NickF93/TheSun/README.md

# TheSun
The Sun: a very bright "portable" spotlight
