NickF93/TheSun/hardware/double_pwm_psu/BOM/BOM_Board1_schematic1_2024-10-07.xlsx

No. | Quantity | Comment | Designator | Footprint | Value | Manufacturer Part | Manufacturer | Supplier Part | Supplier
1 | 1 | 22uF | C1 | C0805 | 22uF | CGA0805X5R226M350MT | HRE(芯声) | C6119901 | LCSC
2 | 1 | 22uF | C2 | C0805 | 22uF | CL21A226MAYNNNE | SAMSUNG(三星) | C602037 | LCSC
3 | 2 | 220nF | CCOMP_B1,CCOMP_B2 | C0402 | 220nF | CL05A224KA5NNNC | SAMSUNG(三星) | C47129 | LCSC
4 | 2 | 100pF | CCS_B1,CCS_B2 | C0402 | 100pF | TCC0402COG101K500AT | CCTC(三环) | C696853 | LCSC
5 | 1 | 10uF | CDSP2 | CAP-SMD_L3.2-W1.6-R-RD |  | TAJA106K010RNJ | AVX | C7177 | LCSC
6 | 1 | 10uF | CF1 | CAP-SMD_L3.5-W2.8 |  | CA45-B025K106T | Xiangyee | C119050 | LCSC
7 | 3 | 1uF | CF2,CF3,CF4 | 0402 |  | CL05A105KA5NQNC | SAMSUNG | C52923 | LCSC
8 | 1 | 1nF | CFPWM1 | C0603 | 1nF | FN18X102K500PSG | PSA(信昌电陶) | C525263 | LCSC
9 | 1 | 10uF | CI4 | CAP-SMD_L3.2-W1.6 |  | CA45-A016K106T | Xiangyee | C119051 | LCSC
10 | 2 | 100uF | CIN_B1,CIN_B5 | CAP-TH_BD10.0-P5.00-D0.6-FD-A | 100uF | 1010631012R00 | NJCON(永立) | C2887235 | LCSC
11 | 2 | 10uF | CIN_B2,CIN_B6 | C0805 | 10uF | CL21A106KAYNNNE | SAMSUNG(三星) | C15850 | LCSC
12 | 2 | 1uF | CIN_B3,CIN_B4 | C0402 | 1uF | CL05A105KA5NQNC | SAMSUNG(三星) | C52923 | LCSC
13 | 2 | WAFER-XH2.54-2PZZ | CN1,CN2 | CONN-TH_XH2.54-2P |  | WAFER-XH2.54-2PZZ | XUNPU(讯普) | C5359631 | LCSC
14 | 1 | DBT50G-7.62-3P-BK-P | CNIN1 | CONN-TH_3P-P7.62_L15.2-W24.4-EX4.2 |  | DBT50G-7.62-3P-BK-P | DIBO(地博电气) | C496128 | LCSC
15 | 2 | WJ25C-B-2P | CNOUT_B2,CNOUT_B3 | CONN-TH_2P-P7.62_WJ25C-B-7.62-2P |  | WJ25C-B-7.62-2P | KANGNEX(康奈克斯电气) | C8422 | LCSC
16 | 2 | 330uF | COUT_B1,COUT_B5 | CAP-TH_BD10.0-P5.00-D1.0-FD | 330uF | RG063M331LO10*20TA-1A1E | BERYL(绿宝石) | C357629 | LCSC
17 | 2 | 220uF | COUT_B2,COUT_B8 | CAP-TH_BD10.0-P5.00-D0.6-FD-A | 220uF | SPZ1JM221G15O00RAXXX | AISHI(艾华集团) | C2983797 | LCSC
18 | 4 | 4.7uF | COUT_B3,COUT_B4,COUT_B6,COUT_B7 | C1210 | 4.7uF | FS32X475K101EGG | PSA(信昌电陶) | C381466 | LCSC
19 | 2 | 470pF | COVP_B3,COVP_B4 | C0402 | 470pF | 0402B471K500NT | FH(风华) | C1537 | LCSC
20 | 1 | 10uF | CPI2 | CASE-C_6032 | 10uF | TAJC106K035RNJ | Kyocera AVX | C7211 | LCSC
21 | 1 | 10uF | CSENSE1 | C0402 | 10uF | CL05A106MQ5NUNC | SAMSUNG(三星) | C15525 | LCSC
22 | 1 | 100nF | CSENSE2 | C0402 |  | TCC0402X7R104K160AT | CCTC(三环) | C392963 | LCSC
23 | 1 | B5819W | D1 | SOD-123F_L2.7-W1.6-LS3.8-RD-1 |  | B5819W | GOODWORK(固得沃克) | C2943878 | LCSC
24 | 1 | K7812-1000 | DCDC1 | PWRM-TH_K78XX-1000 |  | K7812-1000 | JETEKPS(健特) | C5199013 | LCSC
25 | 6 | MMSD4148T3G | DCS_B1,DCS_B2,DCS_B3,DCS_B4,DGATE_B1,DGATE_B2 | SOD-123FL_L2.6-W1.6-LS3.4-RD |  | MMSD4148T3G | ONSemicon | C232560 | LCSC
26 | 1 | CUS08F30,H3F | DPWM1 | SOD-323F_L2.0-W1.6-LS2.5-RD |  | CUS08F30,H3F | TOSHIBA(东芝) | C150183 | LCSC
27 | 1 | 2.54-1*4P母 | DSP | HDR-TH_4P-P2.54-V-F |  | 2.54-1*4P母 | BOOMELE(博穆精密) | C2718488 | LCSC
28 | 2 | ST2045 | DS_B1,DS_B2 | TO-277_3P-L5.4-W4.0-LS6.5-BR |  | ST2045 | MDD（MicrodiodeElectronics） | C840773 | LCSC
29 | 1 | XF-507P | F1 | CONN-TH_XF-507P |  | XF-507P | XFCN(兴飞) | C668119 | LCSC
30 | 1 | HF1004E | FAN1 | CONN-TH_4P-P2.54_HF1004E |  | HF1004E | FOXCONN(富士康) | C2761402 | LCSC
31 | 1 | Header-Male-2.54_2x3 | H3 | HDR-TH_6P-P2.54-V-M-R2-C3-S2.54-1 |  | Header-Male-2.54_2x3 | BOOMELE | C65114 | LCSC
32 | 2 | XSD366-094 | HSDRV_B2,HSDRV_B3 | xsd366094 |  | XSD366-094 | XSD |  | LCSC
33 | 4 | 47uH | L_B1,L_B2,L_B4,L_B5 | IND-TH_L17.8-W17.8-P13.00-D0.6 | 47uH | PDPMAA1712-470MP | PROD(谱罗德) | C5119635 | LCSC
34 | 2 | HCB3216KF-300T80 | L_B3,L_B6 | L1206 |  | HCB3216KF-300T80 | TAI-TECH(台庆) | C525677 | LCSC
35 | 2 | LPN1510C | Q_B1,Q_B2 | TO-220-3_L10.0-W4.5-P2.54-L |  | IRFB4110PBF | Infineon Technologies | C2650 | LCSC
36 | 1 | 470Ω | R1 | R0402 | 470Ω | 0402WGJ0471TCE | UNI-ROYAL(厚声) | C25167 | LCSC
37 | 2 | 100Ω | RCSP_B1,RCSP_B2 | R0402 | 100Ω | 0402WGJ0101TCE | UNI-ROYAL(厚声) | C25138 | LCSC
38 | 4 | 60mΩ | RCS_B1,RCS_B2,RCS_B3,RCS_B4 | R2512 | 60mΩ | MA251230FR060FZ | EVER OHMS(天二科技) | C252688 | LCSC
39 | 4 | 130mΩ | RFB_B1,RFB_B2,RFB_B3,RFB_B4 | RES-SMD_L6.4-W3.2-R2512 | 130mΩ | HoLR2512-130mR-1% | Milliohm(毫欧) | C5123648 | LCSC
40 | 1 | 20kΩ | RFPWM1 | R0402 | 20kΩ | SCR0402J20K | VO(翔胜) | C3017501 | LCSC
41 | 7 | 10kΩ | RGATEPD_B1,RGATEPD_B2,RRST2,RSWA,RSWB,RSWC,RSWD | R0402 | 10kΩ | RTT021002FTH | RALEC(旺诠) | C102749 | LCSC
42 | 2 | 10Ω | RGATE_B1,RGATE_B2 | R0402 | 10Ω | 0402WGJ0100TCE | UNI-ROYAL(厚声) | C25139 | LCSC
43 | 2 | 360kΩ | ROVP_B1,ROVP_B4 | R0402 | 360kΩ | 0402WGF3603TCE | UNI-ROYAL(厚声) |  | LCSC
44 | 2 | 18.7kΩ | ROVP_B2,ROVP_B3 | R0402 | 18.7kΩ | 0402WGF1872TCE | UNI-ROYAL(Uniroyal Elec) |  | LCSC
45 | 3 | 1kΩ | RPWM1,RS1,RS2 | R0402 |  | 0402WGJ0102TCE | UNI-ROYAL(厚声) | C25543 | LCSC
46 | 1 | 100Ω | RRST1 | R0402 |  | 0402WGJ0101TCE | UNI-ROYAL(厚声) | C25138 | LCSC
47 | 1 | 220Ω | RSENSE1 | R0402 | 220Ω | 0402WGJ0221TCE | UNI-ROYAL(厚声) | C25151 | LCSC
48 | 2 | 10kΩ | RT1,RT2 | R0402 |  | 0402WGF1002TCE | UNI-ROYAL(厚声) | C25744 | LCSC
49 | 4 | TS4543TP 250gf 009 | SW1,SW2,SW3,SW4 | SW-SMD_4P-L4.5-W4.5-P3.00-LS6.9 |  | TS4543TP 250gf 009 | SHOU HAN(首韩) | C5342984 | LCSC
50 | 1 | TSB008A2518A | SWRST1 | SW-SMD_L6.0-W3.5-LS8.2 |  | TSB008A2518A | BZCN(博众电气) | C2888455 | LCSC
51 | 2 | HC-XH-2A-G | T1,T2 | CONN-TH_2P-P2.50_HC-XH-2A-G |  | HC-XH-2A-G | HCTL(华灿天禄) | C5341201 | LCSC
52 | 1 | AHT20 | U3 | SENSOR-SMD_L3.0-W3.0-P1.00-BR |  | AHT20 | 广州奥松 | C2757850 | LCSC
53 | 1 | ATTINY1616-MNR | U5 | QFN-20_L3.0-W3.0-P0.40-BL-EP1.7 |  | ATTINY1616-MNR | MICROCHIP(美国微芯) | C507118 | LCSC
54 | 1 | SK1117-5.0 | U6 | SOT-223_L6.5-W3.5-P2.30-LS7.0-BR |  | SK1117-5.0 | SHIKUES(时科) | C165483 | LCSC
55 | 2 | AL3353S-13 | UCTRL_B1,UCTRL_B2 | SOIC-8_L4.9-W3.9-P1.27-LS6.0-BL |  | AL3353S-13 | DIODES(美台) | C2678811 | LCSC
