NickF93/TheSun/hardware/double_pwm_psu/PCB/PDF/PCB_PCB1_2024-10-07_BOTTOM.pdf

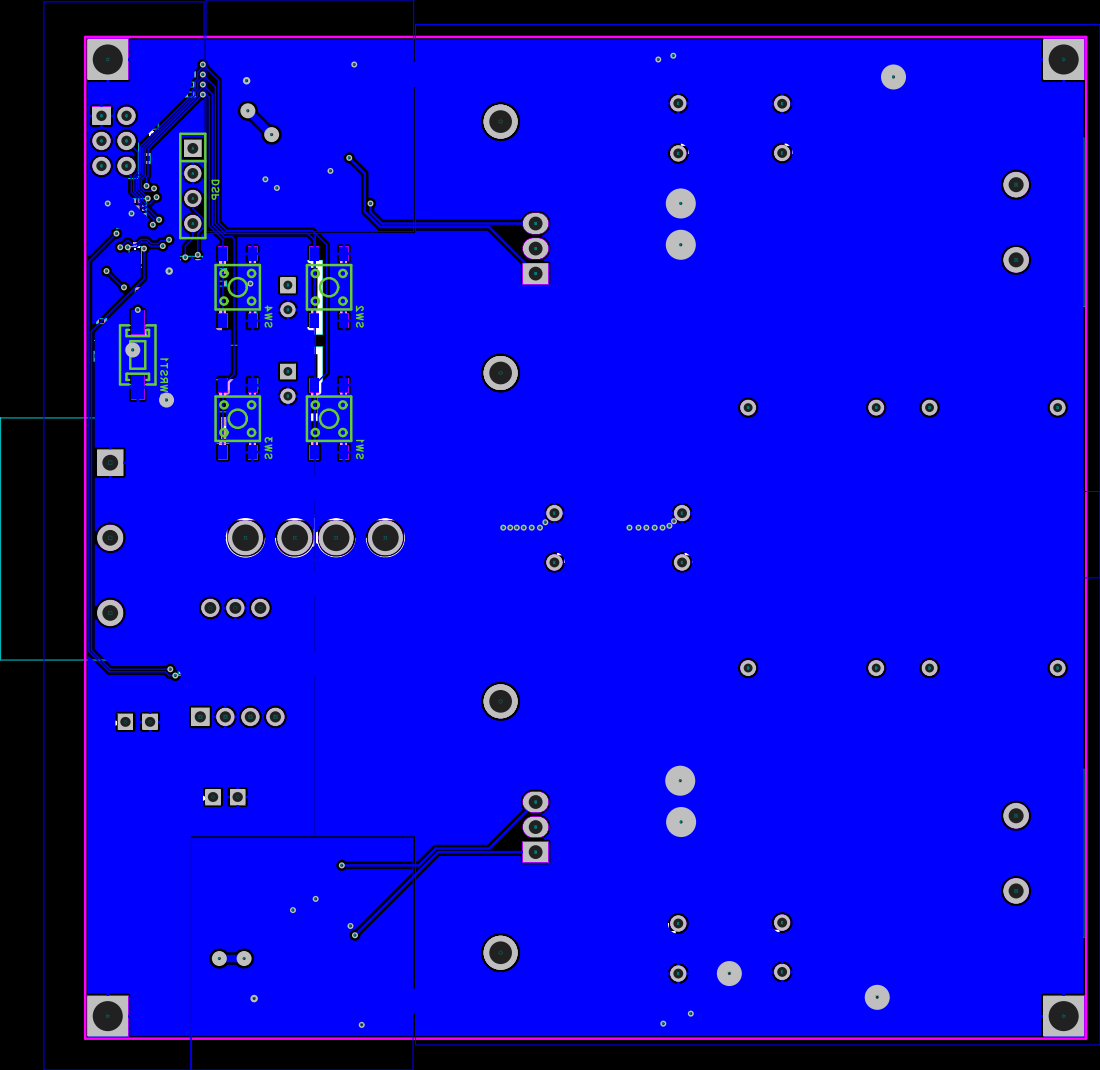
[picture p1: page 1]
