NickF93/TheSun/hardware/double_pwm_psu/PCB/PDF/PCB_PCB1_2024-10-07_TOP.pdf

# CN2U5

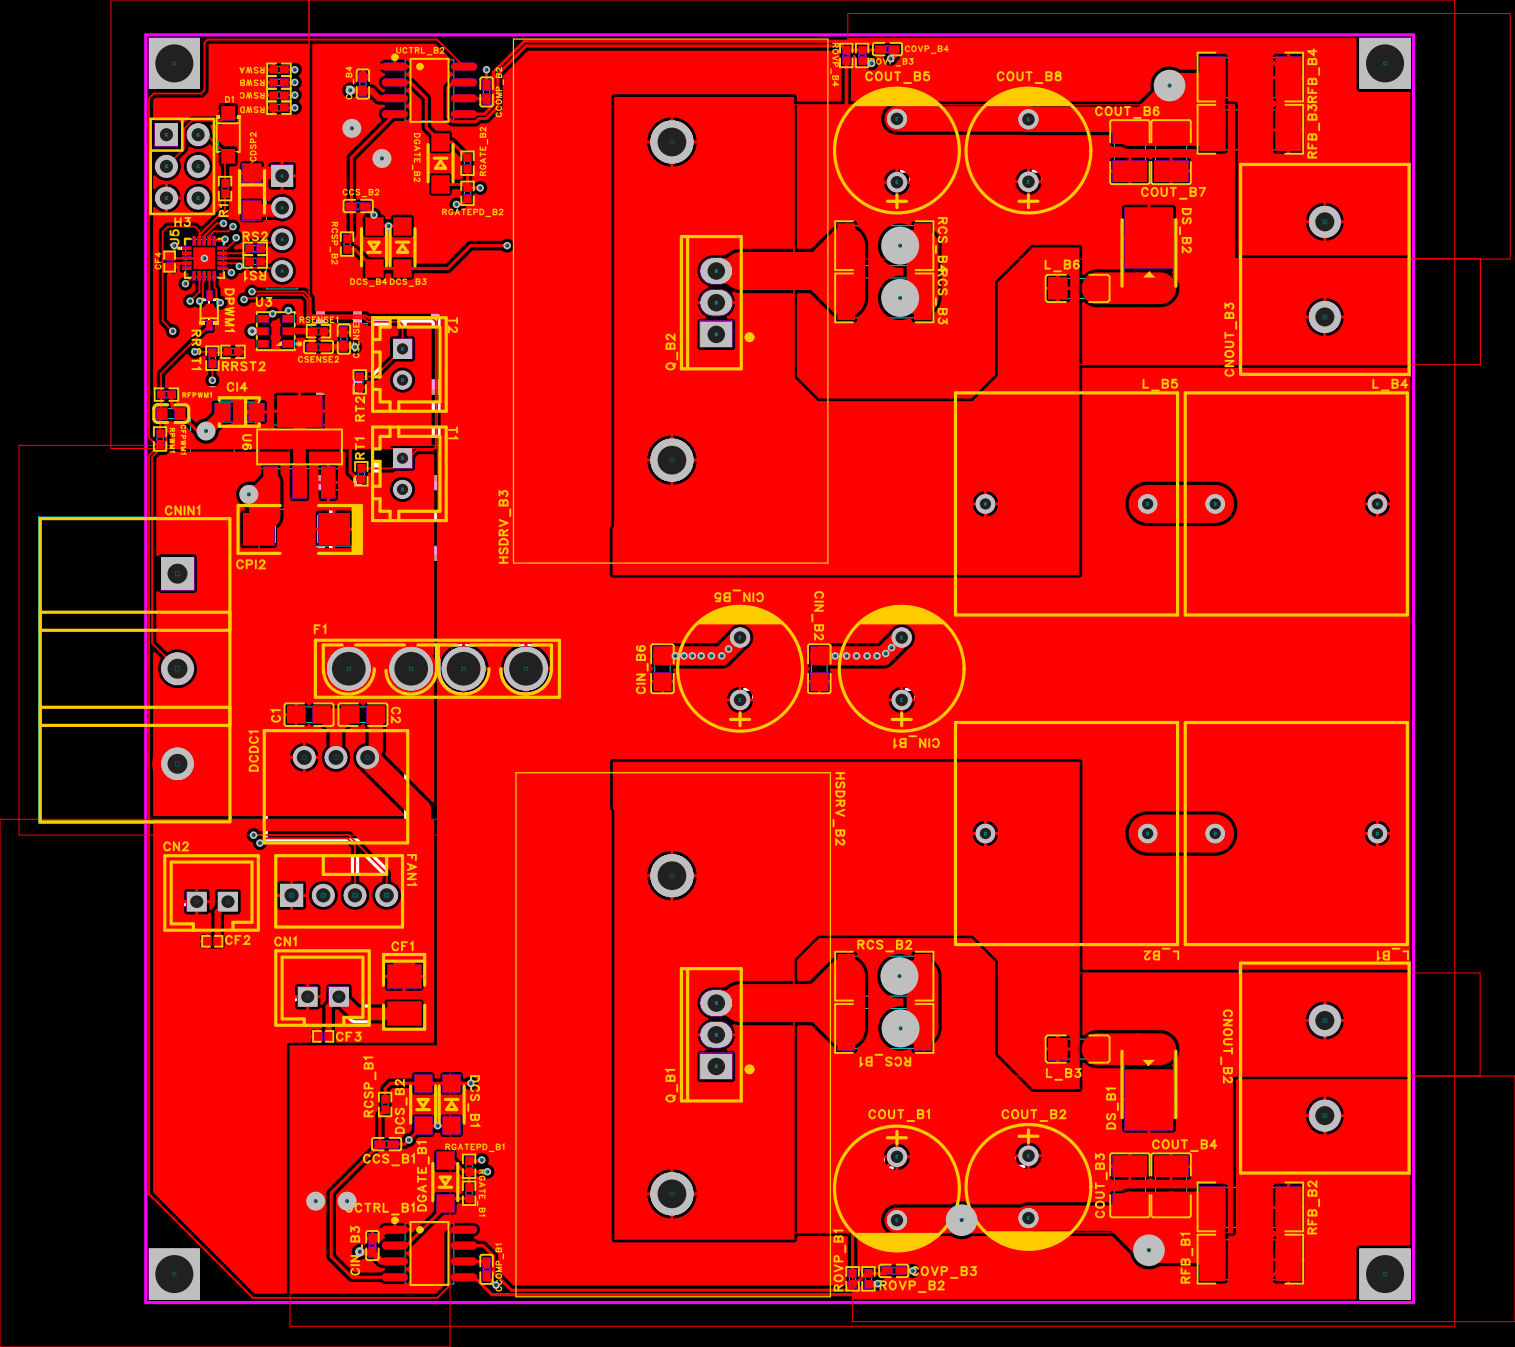
[picture p2: page 1]

COUT_B6
