NickF93/TheSun/hardware/double_pwm_psu/SCH/PDF/SCH_schematic1_2024-10-07.pdf

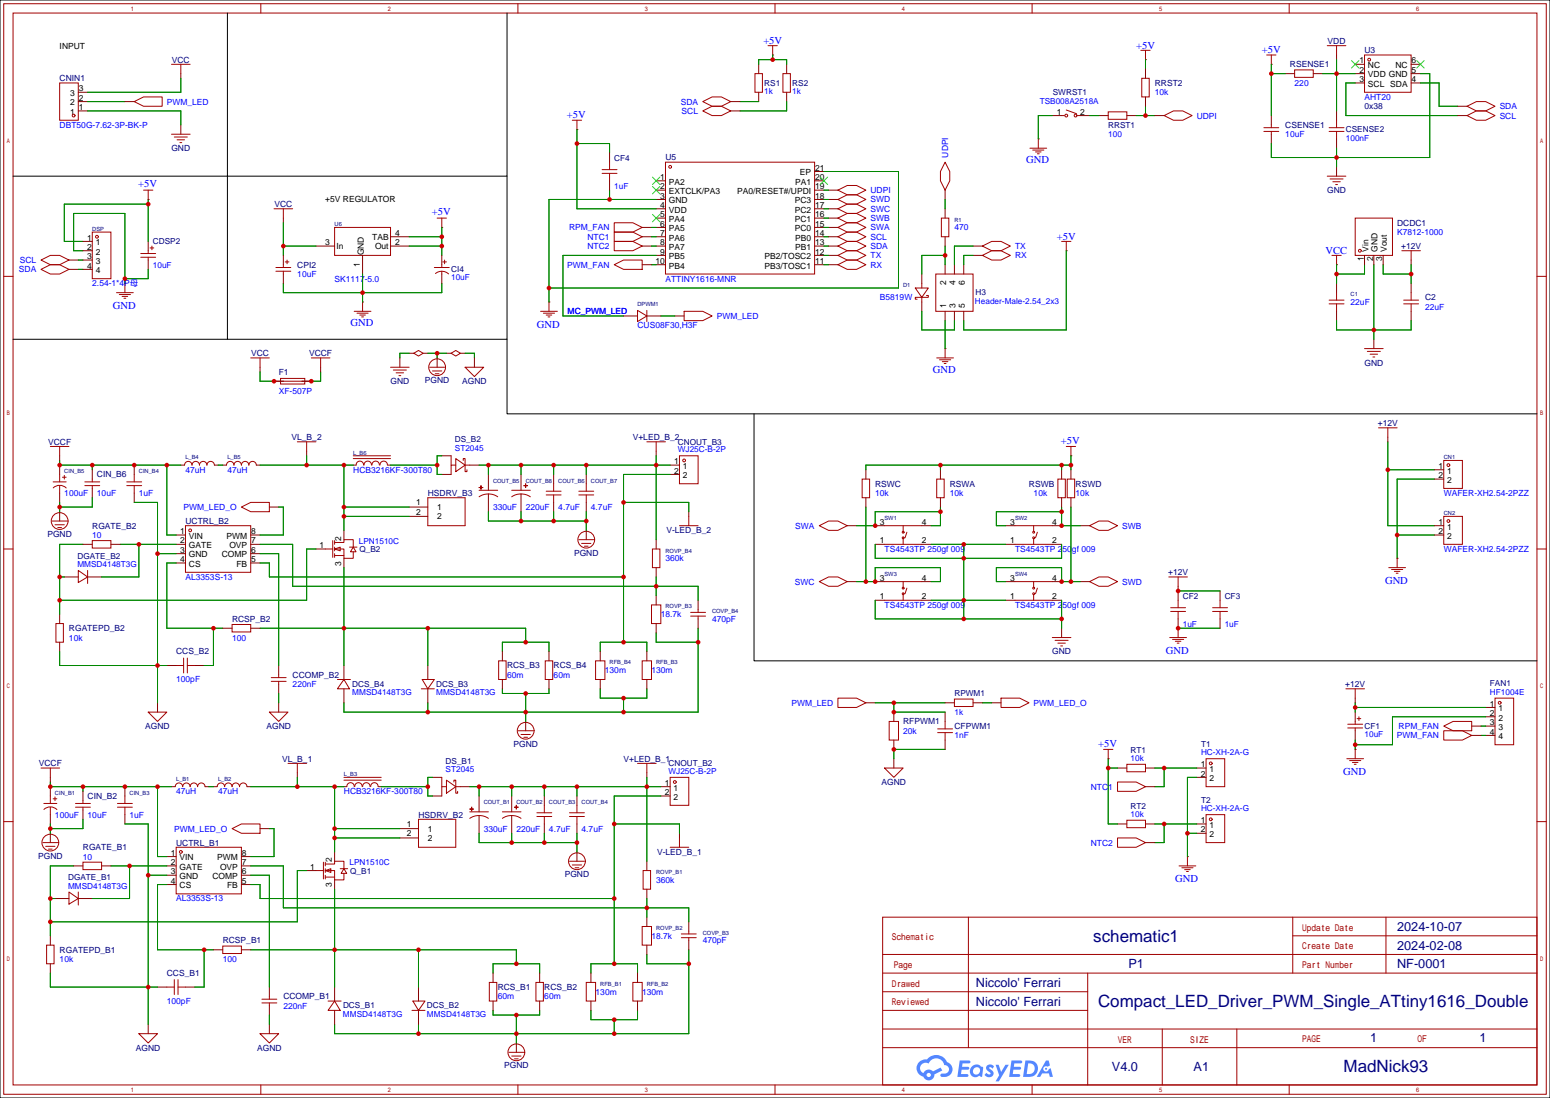
[picture p3: page 1]
