NickF93/TheSun/(list of files, drawings)

Other design files:
hardware/double_pwm_psu/PCB/ProPrj_Compact_LED_Driver_PWM_Single_ATtiny1616_Double_2024-10-07.epro
hardware/double_pwm_psu/SCH/ProPrj_Compact_LED_Driver_PWM_Single_ATtiny1616_Double_2024-10-07.epro
