NickF93/TheSun/(commit log)

2025-12-08 fixes timer&analog write issue
    [main.cpp]
2025-12-09 working on timer and pwm
2025-12-09 removed old arduino firmware
